laemo10/SuperNicePCB/report.txt

Mis à jour TestPoint de GND à GND1.
Annotation terminée.
