laemo10/SuperNicePCB/production/bom.csv

Designator | Footprint | Quantity | Value | LCSC Part #
3.3, 3V3_M, 3V3_S, GND_2, GND | TestPoint_Pad_1.0x1.0mm | 5 | TestPoint
BOOT | PinHeader_1x02_P1.27mm_Vertical_SMD_Pin1Left | 1 | Boot Opt | C703015
C1 | C1859_C1206 | 1 | 22uF | C1859
C10, C11, C5 | C109448_C0603 | 3 | 22uF | C109448
C12, C6, C9 | C1589_C0603 | 3 | 10nF | C1589
C13, C20, C7 | C1713_C0805 | 3 | 10uF | C1713
C14, C15, C17, C18, C19, C2, C3 | C1525_C0402 | 7 | 100nF | C1525
C16 | C1705_C0603 | 1 | 4,7uF | C1705
C4 | C1592_C0603 | 1 | 1uF | C1592
C8 | C76919_C0201 | 1 | 22pF | C76919
H1, H2, H3 | C52016809_HDR-SMD_14P-P2_54-V-M-S4_8 | 3 | 1010301753 | C52016809
L1 | C42100_IND-SMD_L4_0-W4_0 | 1 | 1.5uH | C42100
LED1 | C2289_LED0603-RD | 1 | 0603 | C2289
LED2 | C5139863_LED-SMD_L1_6-W0_8-RD_GREEN-1 | 1 | APHD1608LCGCK | C5139863
R1, R10, R11, R13, R14, R9 | C1489_R1206 | 6 | 10k | C1489
R12, R18, R4, R7 | C14675_R0603 | 4 | 100K | C14675
R15 | C4109_R0402 | 1 | 2K | C4109
R16, R17 | C13167_R0603 | 2 | 2.7k | C13167
R2, R3 | C14677_R0603 | 2 | 5.1K | C14677
R5 | C871504_R1206 | 1 | 90k | C871504
R6 | C4184_R0603 | 1 | 20K | C4184
R8 | C705066_R0402 | 1 | 3.2K | C705066
SW1 | C55200589_SW-SMD_4P-L4_2-W3_4-P2_15-LS5_2 | 1 | Reset | C55200589
U1 | C2913198_WIFIM-SMD_ESP32-S3-WROOM-1-N8 | 1 | ESP32-S3-WROOM-1-N8 | C2913198
U2 | C78988_SOT-23-5_L3_0-W1_7-P0_95-LS2_8-BR | 1 | SY8089AAAC | C78988
U3 | C3294704_VDFN-8_L3_0-W3_0-P0_65-BL-EP | 1 | SGM2048-ADJXTEK8G/TR | C3294704
U4 | C5656610_MIC-SMD_6P-L3_5-W2_7-P0_90-BL | 1 | ICS-43434_C5656610 | C5656610
U5 | C114881_TO-5-3_L8_2-W8_2 | 1 | AM312 | C114881
U6 | C3037696_LGA-20_L10_1-W10_1-P1_25-TL | 1 | SCD40-D-R1 | C3037696
U7 | C2848306_DFN-4_L1_5-W1_5-P0_8-TL-EP | 1 | SHT40-AD1B-R3 | C2848306
U8 | C37897213_SENSOR-TH_HLK-LD6002 | 1 | HLK-LD6002 | C37897213
U9 | C5299931_WIRELM-SMD_DWM3000TR13 | 1 | DWM3000TR13 | C5299931
UART | PinHeader_1x04_P1.27mm_Vertical_SMD_Pin1Left | 1 | UART Debug | C22438101
USBC1 | C165948_USB-C_SMD-TYPE-C-31-M-12_1 | 1 | TYPE-C-31-M-12 | C165948
