laemo10/SuperNicePCB/SuperNicePCB.kicad_pcb

## KiCad design SuperNicePCB.kicad_pcb (2026-10-15)

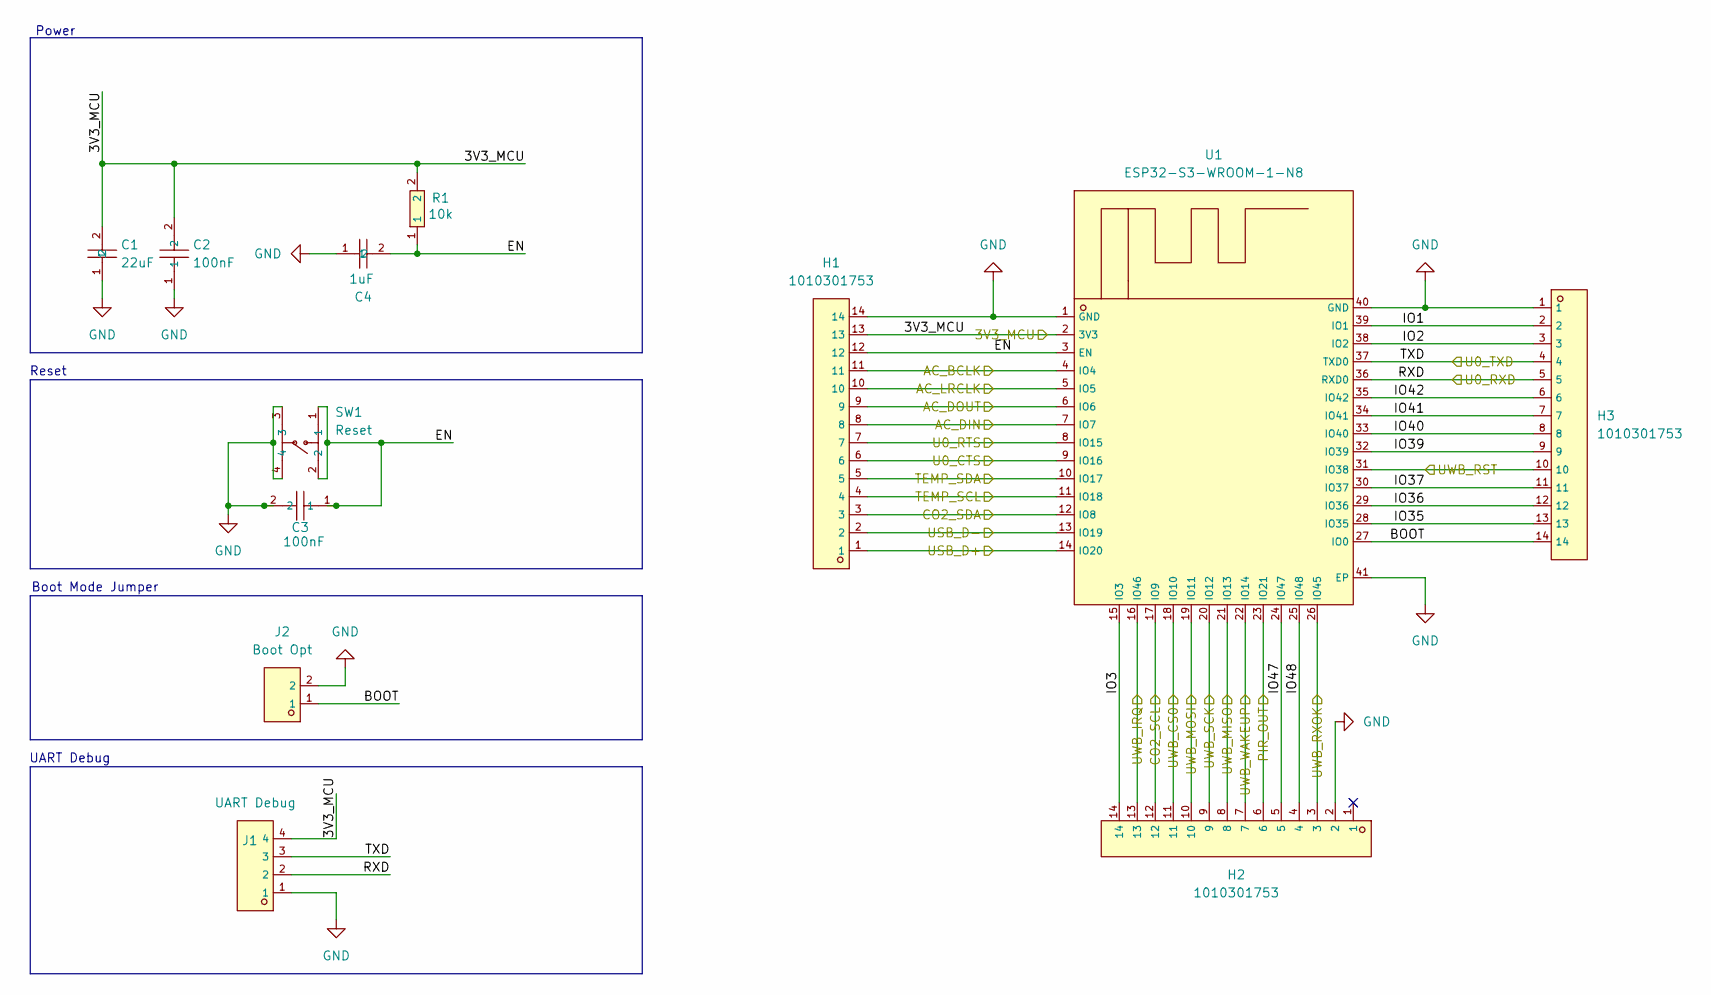
[picture p1: schematic MCU.kicad_sch]

Parts:
C1: 22uF; C1859_C1206; LCSC C1859
C2, C3: 100nF; C1525_C0402; LCSC C1525
C4: 1uF; C1592_C0603; LCSC C1592
H1, H2, H3: 1010301753; C52016809_HDR-SMD_14P-P2_54-V-M-S4_8; LCSC C52016809
J1: UART Debug; PinHeader_1x04_P1.27mm_Vertical_SMD_Pin1Left; LCSC C22438101
J2: Boot Opt; PinHeader_1x02_P1.27mm_Vertical_SMD_Pin1Left; LCSC C703015
R1: 10k; C1489_R1206; LCSC C1489
SW1: Reset; C55200589_SW-SMD_4P-L4_2-W3_4-P2_15-LS5_2; LCSC C55200589
U1: ESP32-S3-WROOM-1-N8; C2913198_WIFIM-SMD_ESP32-S3-WROOM-1-N8; LCSC C2913198

Connections:
/HumanSesors/AC_BCLK: H1.11, U1.4 (IO4); also elsewhere on the board
/HumanSesors/AC_LRCLK: H1.10, U1.5 (IO5); also elsewhere on the board
/HumanSesors/C02_SDA: H1.3, U1.12 (IO8); also elsewhere on the board
/HumanSesors/CO2_SCL: H2.12, U1.17 (IO9); also elsewhere on the board
/HumanSesors/DIN: H1.8, U1.7 (IO7); also elsewhere on the board
/HumanSesors/U0_CTS: H1.6, U1.9 (IO16); also elsewhere on the board
/HumanSesors/U0_RTS: H1.7, U1.8 (IO15); also elsewhere on the board
/MCU/3V3_MCU: C1.2, C2.2, H1.13, J1.4, R1.2, U1.2 (3V3); also elsewhere on the board
/MCU/AC_DOUT: H1.9, U1.6 (IO6)
/MCU/BOOT: H3.14, J2.1, U1.27 (IO0); also elsewhere on the board
/MCU/EN: C3.1, C4.2, H1.12, R1.1, SW1.1, SW1.2, U1.3 (EN)
/MCU/IO1: H3.2, U1.39 (IO1)
/MCU/IO2: H3.3, U1.38 (IO2)
/MCU/IO3: H2.14, U1.15 (IO3)
/MCU/IO35: H3.13, U1.28 (IO35)
/MCU/IO36: H3.12, U1.29 (IO36)
/MCU/IO37: H3.11, U1.30 (IO37)
/MCU/IO39: H3.9, U1.32 (IO39)
/MCU/IO40: H3.8, U1.33 (IO40)
/MCU/IO41: H3.7, U1.34 (IO41)
/MCU/IO42: H3.6, U1.35 (IO42)
/MCU/IO47: H2.5, U1.24 (IO47)
/MCU/IO48: H2.4, U1.25 (IO48)
/MCU/RXD: H3.5, J1.2, U1.36 (RXD0); also elsewhere on the board
/MCU/TXD: H3.4, J1.3, U1.37 (TXD0); also elsewhere on the board
/MCU/UWB_CS0: H2.11, U1.18 (IO10); also elsewhere on the board
/MCU/UWB_IRQ: H2.13, U1.16 (IO46); also elsewhere on the board
/MCU/UWB_MISO: H2.8, U1.21 (IO13); also elsewhere on the board
/MCU/UWB_MOSI: H2.10, U1.19 (IO11); also elsewhere on the board
/MCU/UWB_RST: H3.10, U1.31 (IO38); also elsewhere on the board
/MCU/UWB_RXOK: H2.3, U1.26 (IO45); also elsewhere on the board
/MCU/UWB_SCK: H2.9, U1.20 (IO12); also elsewhere on the board
/MCU/UWB_WAKEUP: H2.7, U1.22 (IO14); also elsewhere on the board
/PIR_OUT: H2.6, U1.23 (IO21); also elsewhere on the board
/TEMP_SCL: H1.4, U1.11 (IO18); also elsewhere on the board
/TEMP_SDA: H1.5, U1.10 (IO17); also elsewhere on the board
/USB_D+: H1.1, U1.14 (IO20); also elsewhere on the board
/USB_D-: H1.2, U1.13 (IO19); also elsewhere on the board
GND: C1.1, C2.1, C3.2, C4.1, H1.14, H2.2, H3.1, J1.1, J2.2, SW1.3, SW1.4, U1.1 (GND), U1.40 (GND), U1.41 (EP); also elsewhere on the board

Notes on the sheet:
Boot Mode Jumper
Power
UART Debug
Reset

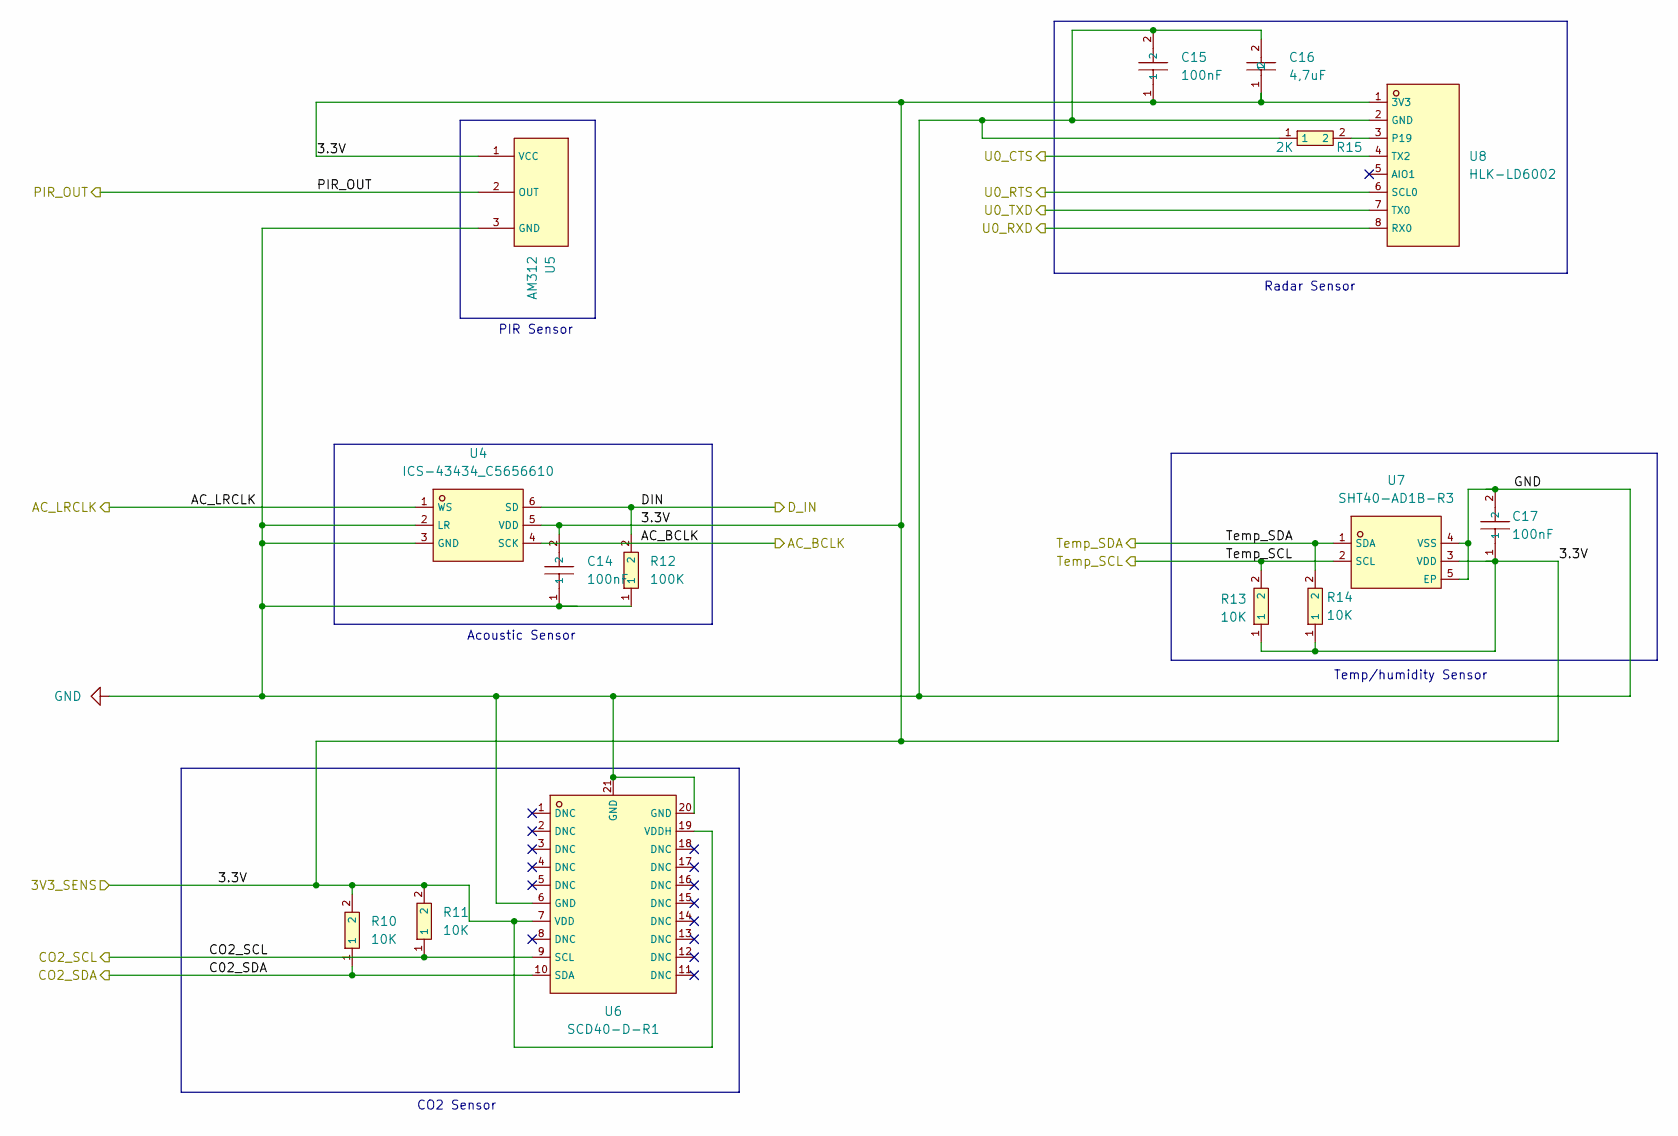
[picture p2: schematic HumanSensors.kicad_sch]

Parts:
C14, C15, C17: 100nF; C1525_C0402; LCSC C1525
C16: 4,7uF; C1705_C0603; LCSC C1705
R10, R11, R13, R14: 10K; C1489_R1206; LCSC C1489
R12: 100K; C14675_R0603; LCSC C14675
R15: 2K; C4109_R0402; LCSC C4109
U4: ICS-43434_C5656610; C5656610_MIC-SMD_6P-L3_5-W2_7-P0_90-BL; LCSC C5656610
U5: AM312; C114881_TO-5-3_L8_2-W8_2; LCSC C114881
U6: SCD40-D-R1; C3037696_LGA-20_L10_1-W10_1-P1_25-TL; LCSC C3037696
U7: SHT40-AD1B-R3; C2848306_DFN-4_L1_5-W1_5-P0_8-TL-EP; LCSC C2848306
U8: HLK-LD6002; C37897213_SENSOR-TH_HLK-LD6002; LCSC C37897213

Connections:
/HumanSesors/3.3V: C14.2, C15.1, C16.1, C17.1, R10.2, R11.2, R13.1, R14.1, U4.5 (VDD), U5.1 (VCC), U6.7 (VDD), U6.19 (VDDH), U7.3 (VDD), U8.1 (3V3); also elsewhere on the board
/HumanSesors/AC_BCLK: U4.4 (SCK); also elsewhere on the board
/HumanSesors/AC_LRCLK: U4.1 (WS); also elsewhere on the board
/HumanSesors/C02_SDA: R10.1, U6.10 (SDA); also elsewhere on the board
/HumanSesors/CO2_SCL: R11.1, U6.9 (SCL); also elsewhere on the board
/HumanSesors/DIN: R12.2, U4.6 (SD); also elsewhere on the board
/HumanSesors/U0_CTS: U8.4 (TX2); also elsewhere on the board
/HumanSesors/U0_RTS: U8.6 (SCL0); also elsewhere on the board
/MCU/RXD: U8.8 (RX0); also elsewhere on the board
/MCU/TXD: U8.7 (TX0); also elsewhere on the board
/PIR_OUT: U5.2 (OUT); also elsewhere on the board
/TEMP_SCL: R13.2, U7.2 (SCL); also elsewhere on the board
/TEMP_SDA: R14.2, U7.1 (SDA); also elsewhere on the board
GND: C14.1, C15.2, C16.2, C17.2, R12.1, R15.1, U4.2 (LR), U4.3 (GND), U5.3 (GND), U6.6 (GND), U6.20 (GND), U6.21 (GND), U7.4 (VSS), U7.5 (EP), U8.2 (GND); also elsewhere on the board
unnamed: R15.2, U8.3 (P19)

Notes on the sheet:
Acoustic Sensor
PIR Sensor
Radar Sensor
Temp/humidity Sensor
CO2 Sensor

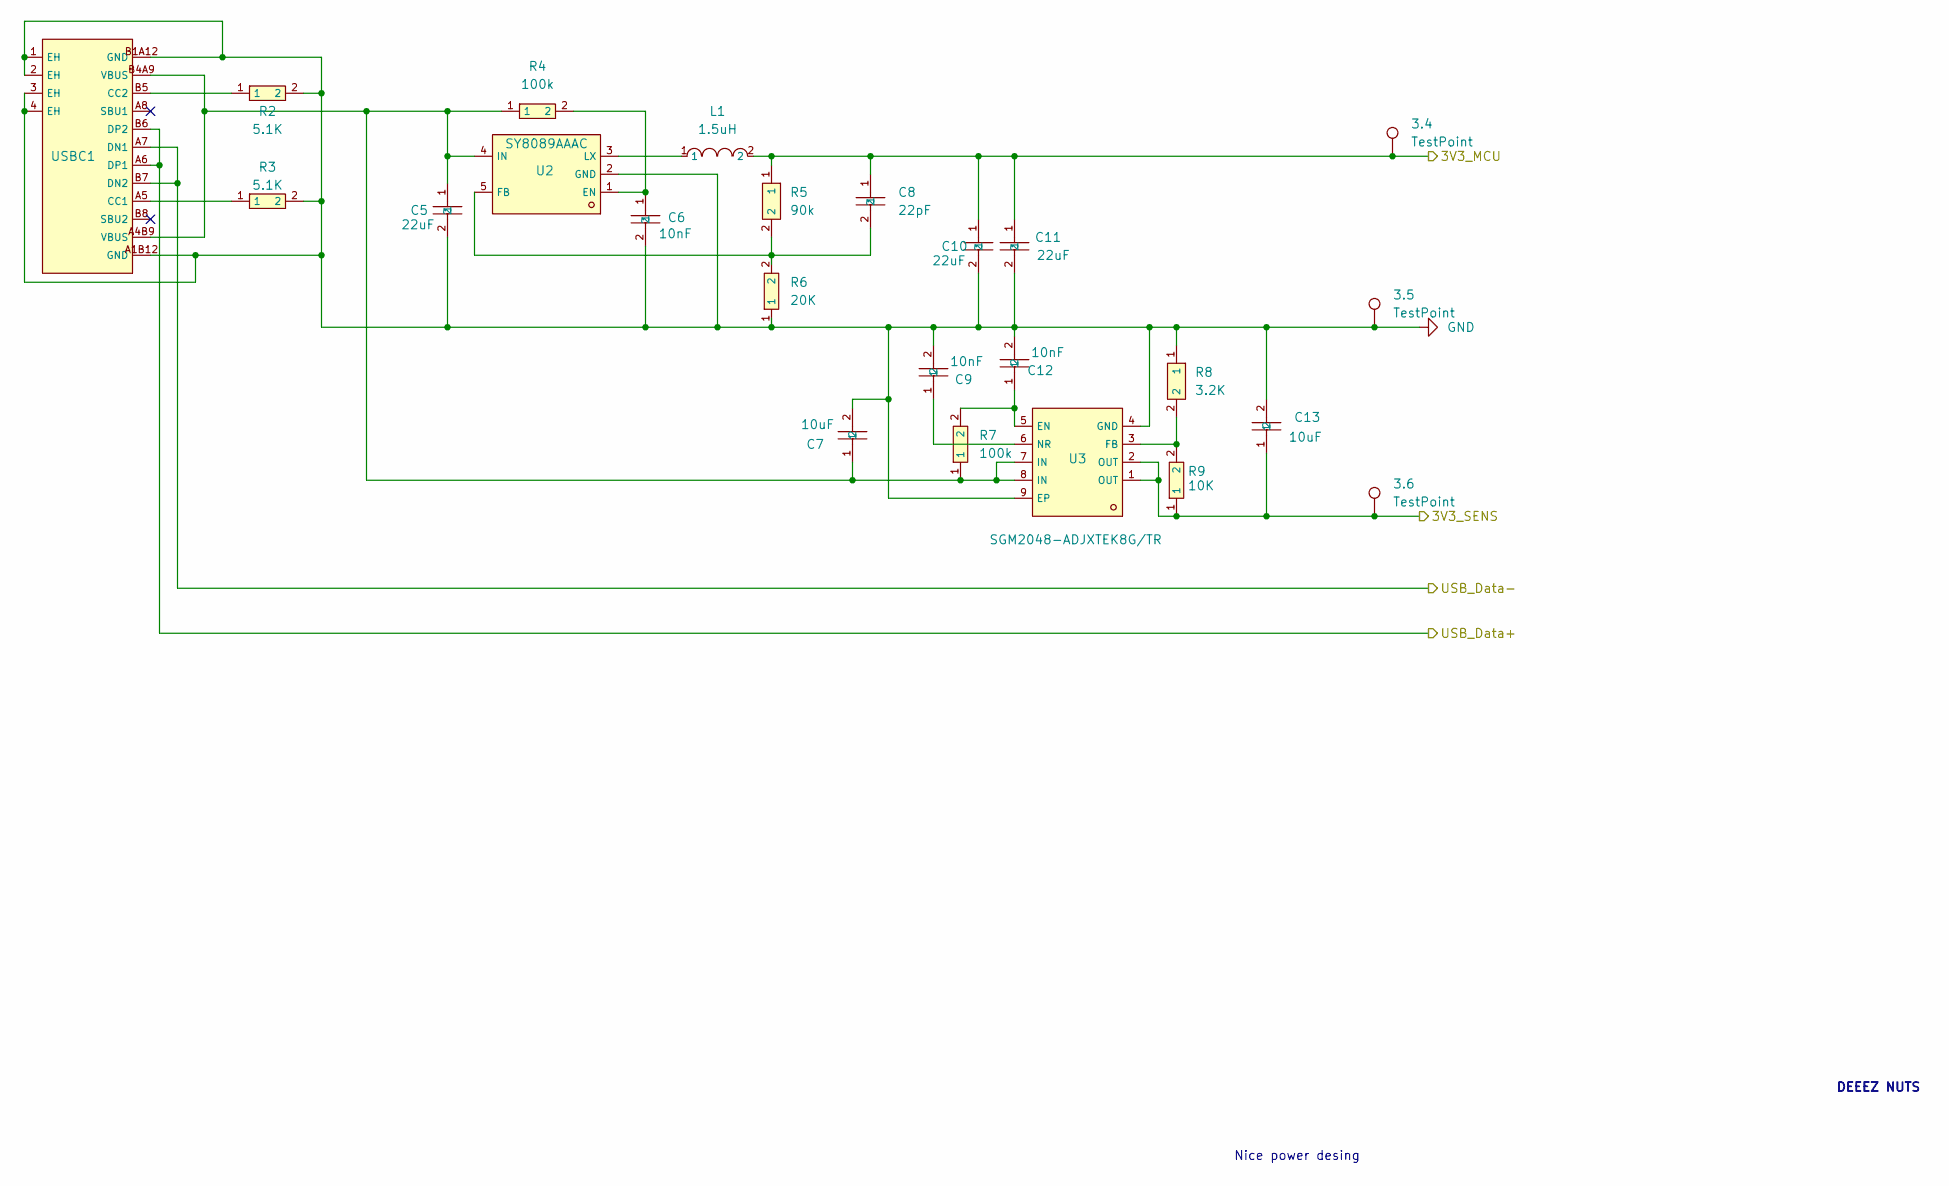
[picture p3: schematic Power.kicad_sch]

Parts:
3.4, 3.5, 3.6: TestPoint; TestPoint_Pad_1.0x1.0mm
C5, C10, C11: 22uF; C109448_C0603; LCSC C109448
C6, C9, C12: 10nF; C1589_C0603; LCSC C1589
C7, C13: 10uF; C1713_C0805; LCSC C1713
C8: 22pF; C76919_C0201; LCSC C76919
L1: 1.5uH; C42100_IND-SMD_L4_0-W4_0; LCSC C42100
R2, R3: 5.1K; C14677_R0603; LCSC C14677
R4, R7: 100k; C14675_R0603; LCSC C14675
R5: 90k; C871504_R1206; LCSC C871504
R6: 20K; C4184_R0603; LCSC C4184
R8: 3.2K; C705066_R0402; LCSC C705066
R9: 10K; C1489_R1206; LCSC C1489
U2: SY8089AAAC; C78988_SOT-23-5_L3_0-W1_7-P0_95-LS2_8-BR; LCSC C78988
U3: SGM2048-ADJXTEK8G/TR; C3294704_VDFN-8_L3_0-W3_0-P0_65-BL-EP; LCSC C3294704
USBC1: TYPE-C-31-M-12; C165948_USB-C_SMD-TYPE-C-31-M-12_1; LCSC C165948

Connections:
/HumanSesors/3.3V: C13.1, R9.1, U3.1 (OUT), U3.2 (OUT); also elsewhere on the board
/MCU/3V3_MCU: C8.1, C10.1, C11.1, L1.2, R5.1; also elsewhere on the board
/USB_D+: USBC1.A6 (DP1), USBC1.B6 (DP2); also elsewhere on the board
/USB_D-: USBC1.A7 (DN1), USBC1.B7 (DN2); also elsewhere on the board
GND: C5.2, C6.2, C7.2, C9.2, C10.2, C11.2, C12.2, C13.2, R2.2, R3.2, R6.1, R8.1, U2.2 (GND), U3.4 (GND), U3.9 (EP), USBC1.1 (EH), USBC1.2 (EH), USBC1.3 (EH), USBC1.4 (EH), USBC1.A1B12 (GND), USBC1.B1A12 (GND); also elsewhere on the board
unnamed: C6.1, R4.2, U2.1 (EN)
unnamed: C8.2, R5.2, R6.2, U2.5 (FB)
unnamed: C5.1, C7.1, R4.1, R7.1, U2.4 (IN), U3.7 (IN), U3.8 (IN), USBC1.A4B9 (VBUS), USBC1.B4A9 (VBUS)
unnamed: L1.1, U2.3 (LX)
unnamed: C12.1, R7.2, U3.5 (EN)
unnamed: R8.2, R9.2, U3.3 (FB)
unnamed: C9.1, U3.6 (NR)
unnamed: R3.1, USBC1.A5 (CC1)
unnamed: R2.1, USBC1.B5 (CC2)

Notes on the sheet:
Nice power desing
DEEEZ NUTS

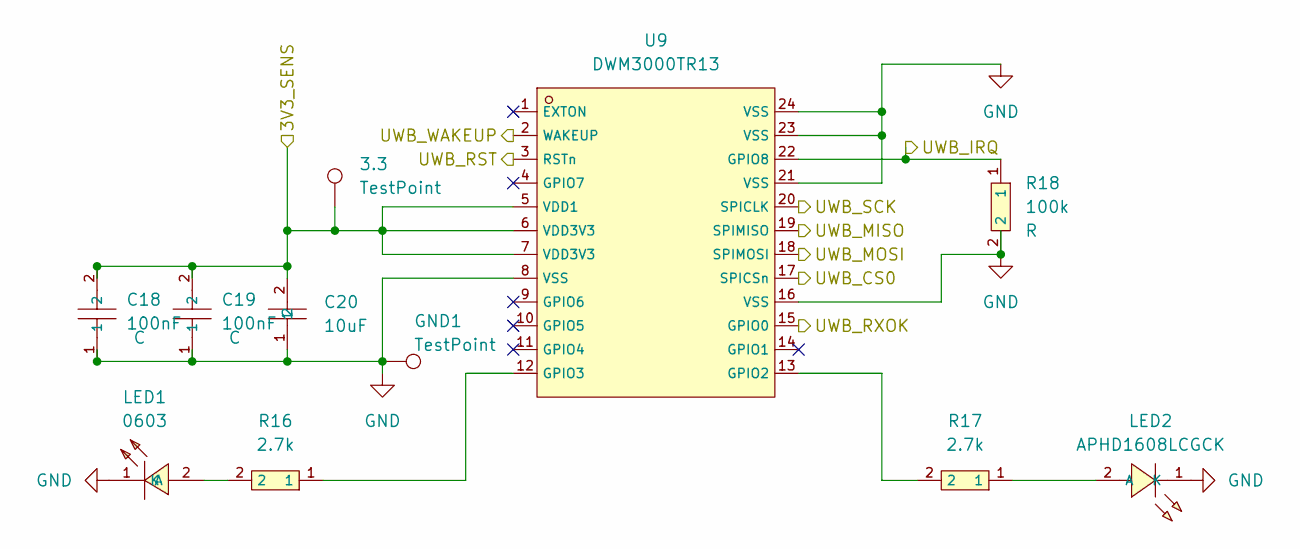
[picture p4: schematic UWB.kicad_sch]

Parts:
3.3: TestPoint; TestPoint_Pad_1.0x1.0mm
C18, C19: 100nF; C1525_C0402; LCSC C1525
C20: 10uF; C1713_C0805; LCSC C1713
GND1: TestPoint; TestPoint_Pad_1.0x1.0mm
LED1: 0603; C2289_LED0603-RD; LCSC C2289
LED2: APHD1608LCGCK; C5139863_LED-SMD_L1_6-W0_8-RD_GREEN-1; LCSC C5139863
R16, R17: 2.7k; C13167_R0603; LCSC C13167
R18: 100k; C14675_R0603; LCSC C14675
U9: DWM3000TR13; C5299931_WIRELM-SMD_DWM3000TR13; LCSC C5299931

Connections:
/HumanSesors/3.3V: 3.3.1 (1_1), C18.2, C19.2, C20.2, U9.5 (VDD1), U9.6 (VDD3V3), U9.7 (VDD3V3); also elsewhere on the board
/MCU/UWB_CS0: U9.17 (SPICSn); also elsewhere on the board
/MCU/UWB_IRQ: R18.1, U9.22 (GPIO8); also elsewhere on the board
/MCU/UWB_MISO: U9.19 (SPIMISO); also elsewhere on the board
/MCU/UWB_MOSI: U9.18 (SPIMOSI); also elsewhere on the board
/MCU/UWB_RST: U9.3 (RSTn); also elsewhere on the board
/MCU/UWB_RXOK: U9.15 (GPIO0); also elsewhere on the board
/MCU/UWB_SCK: U9.20 (SPICLK); also elsewhere on the board
/MCU/UWB_WAKEUP: U9.2 (WAKEUP); also elsewhere on the board
GND: C18.1, C19.1, C20.1, GND1.1, LED1.1 (K), LED2.1 (K), R18.2, U9.8 (VSS), U9.16 (VSS), U9.21 (VSS), U9.23 (VSS), U9.24 (VSS); also elsewhere on the board
unnamed: LED1.2 (A), R16.2
unnamed: LED2.2 (A), R17.1
unnamed: R17.2, U9.13 (GPIO2)
unnamed: R16.1, U9.12 (GPIO3)

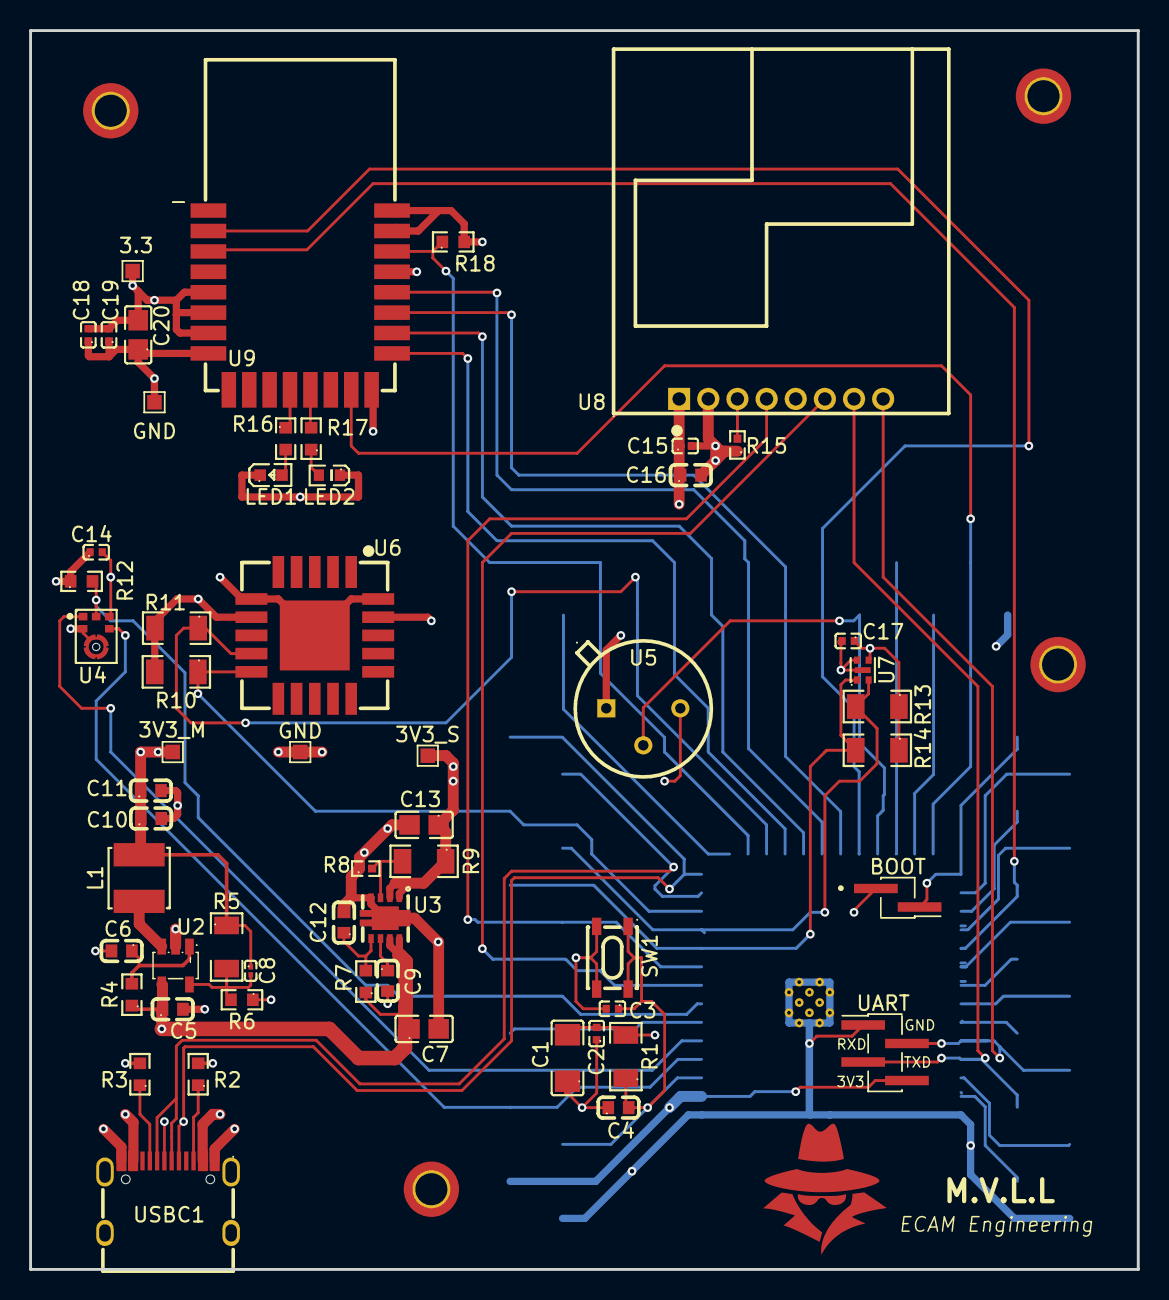
[picture p5: board SuperNicePCB.kicad_pcb from above]

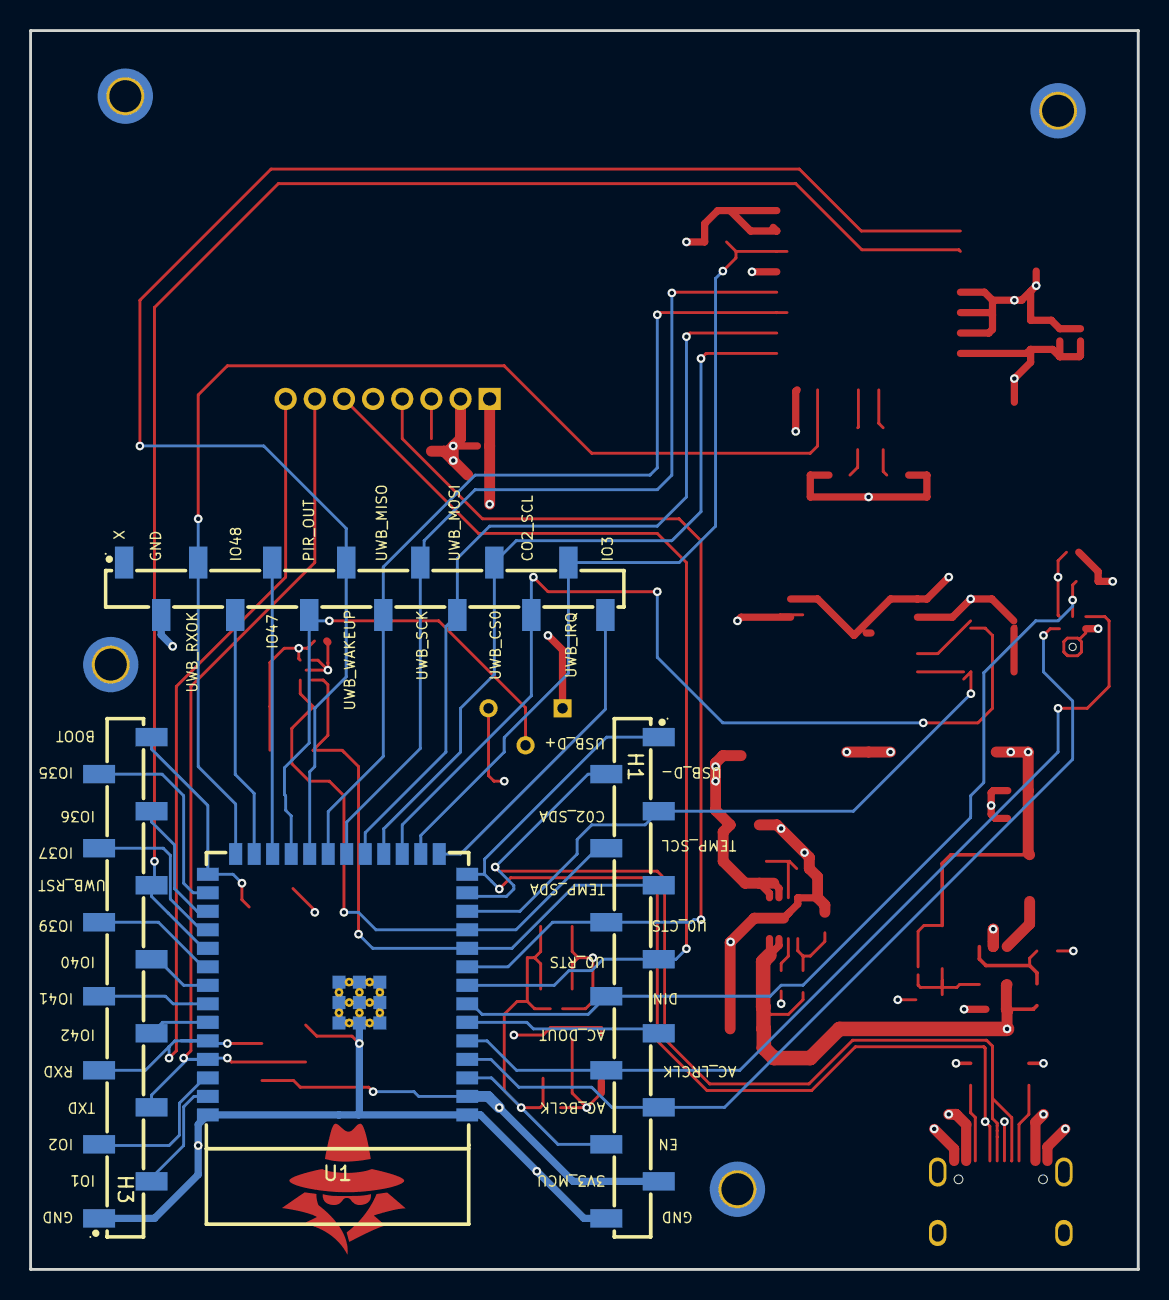
[picture p6: board SuperNicePCB.kicad_pcb from below]

Board: 4 copper layers, 76.0 x 85.0 mm, 62 parts (4 on the bottom side), 54 nets.

Other parts of the board:
3V3_M, 3V3_S: TestPoint; TestPoint_Pad_1.0x1.0mm
BOOT: Boot Opt; PinHeader_1x02_P1.27mm_Vertical_SMD_Pin1Left
GND: TestPoint; TestPoint_Pad_1.0x1.0mm
GND#2: TestPoint; TestPoint_Pad_1.0x1.0mm
UART: UART Debug; PinHeader_1x04_P1.27mm_Vertical_SMD_Pin1Left

Their connections:
/HumanSesors/3.3V: 3V3_S.1 (1_1); also elsewhere on the board
/MCU/3V3_MCU: 3V3_M.1 (1_1), UART.4; also elsewhere on the board
/MCU/BOOT: BOOT.1; also elsewhere on the board
/MCU/RXD: UART.2; also elsewhere on the board
/MCU/TXD: UART.3; also elsewhere on the board
GND: BOOT.2, GND.1 (1_1), GND#2.1 (1_1), UART.1; also elsewhere on the board
