laemo10/SuperNicePCB/(commit log)

2026-09-24 Initial snapshot: 3 files changed SuperNicePCB.kicad_pcb 2/0/0 SuperNicePCB.kicad_pro 1/0/0 SuperNicePCB.kicad_sch 14/0/0
    [SuperNicePCB.kicad_pcb, SuperNicePCB.kicad_sch]
2026-09-24 Adding gitignore
    [SuperNicePCB.kicad_pcb, SuperNicePCB.kicad_sch]
2026-09-24 Update root
    [SuperNicePCB.kicad_pcb, SuperNicePCB.kicad_sch]
2026-09-24 Add subsection
    [HumanSensors.kicad_sch, Power.kicad_sch, SuperNicePCB.kicad_sch, UWB.kicad_sch, mcu.kicad_sch]
2026-09-24 Buck converter for main power of the esp 32 and LDO converter for sensor
    Power Design
    [Power.kicad_sch]
2026-09-24 Beauty fixes
    [Power.kicad_sch]
2026-09-24 UWB: DWM3000 schematic with decoupling, IRQ pulldown and status LEDs
    [UWB.kicad_sch]
2026-09-24 Added global lables
    [Power.kicad_sch]
2026-09-24 Add project symbol and footprint libraries (LCSC imports)
2026-09-24 Global label modified
    [Power.kicad_sch]
2026-09-24 Add MCU
    [SuperNicePCB.kicad_pcb, mcu.kicad_sch]
2026-09-24 Human sensors
    [CO2sensors.kicad_sch, HumanSensors.kicad_sch, TemphumSensor.kicad_sch]
2026-09-24 UWB: restore full schematic (decoupling, LED resistors, IRQ pulldown, hierarchical labels)
    [UWB.kicad_sch]
2026-09-29 Clean: deduplicate symbol library and fix UUIDs
    - libs/lcsc/symbols/lcsc_imported.kicad_sym: merged 4 concatenated
    kicad_symbol_lib sections into one. Removed 8 duplicate symbol
    definitions (SCD40-D-R1, SHT40-AD1B-R3, DWM3000TR13, 0603,
    CC0603MRX5R5BB226, 22pF_(220), ESP32-S3-WROOM-1-N8 and their _1_1
    sub-units). Library reduced from 6407 to 4416 lines.
    - mcu.kicad_sch: fix duplicate UUIDs on decoupling cap pins
    - SuperNicePCB.kicad_sch: add missing UWB hierarchical label pins
    (UWB_CLK, UWB_CSn, UWB_IRQ, UWB_MISO, UWB_MOSI, UWB_RSTn, UWB_WAKE)
    - SuperNicePCB.kicad_pro: clear stale used_designators cache
    [SuperNicePCB.kicad_sch, mcu.kicad_sch]
2026-09-29 Ajout du label UWB_RXOK pour la pin GPIO 0
    [UWB.kicad_sch]
2026-09-29 Rework MCU and Human sensor
    [HumanSensors.kicad_sch, mcu.kicad_sch]
2026-09-29 Error correction
    Corrected resistor value for LDO and added slow rise resistor and capacitorfor LDO
    [Power.kicad_sch]
2026-09-29 Fix: repair symbol library structure from broken cherry-pick conflict
    The 'Error correction' cherry-pick (b00e793) introduced two issues
    in libs/lcsc/symbols/lcsc_imported.kicad_sym during conflict resolution:
    - An extra spurious ')' was inserted before RT0402BRD073K2L, causing
    kicad_symbol_lib to close prematurely (1 extra closing paren)
    - RT0402BRD073K2L symbol was placed at 0-indent instead of 2-indent
    Fixed by:
    - Removing the extra spurious ')'
    - Re-indenting RT0402BRD073K2L block to 2-space indent (standard format)
    - File now has 1 kicad_symbol_lib section, 27 unique symbols, balanced parens
    Also removed misplaced Power.kicad_pcb/ directory, Power.kicad_pro and
    Power.kicad_sch which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
    [Power.kicad_sch]
2026-09-29 Restore Power.kicad_sch (accidentally deleted in cleanup)
    [Power.kicad_sch]
2026-09-29 Final Routing
    [Power.kicad_sch, SuperNicePCB.kicad_sch, UWB.kicad_sch, mcu.kicad_sch]
2026-09-29 UWB: add test points
    [UWB.kicad_sch]
2026-09-29 refactor: reposition GPIO debug connector and update schematic wiring
    [UWB.kicad_sch, mcu.kicad_sch]
2026-09-30 Annotate whole schematic with per-sheet numbering (x100)
    [Power.kicad_sch, SuperNicePCB.kicad_pcb, UWB.kicad_sch]
2026-10-01 Changed the default symbols with JLC's one
    [HumanSensors.kicad_sch, UWB.kicad_sch, mcu.kicad_sch]
2026-10-01 Changed footprint of the test point
    [HumanSensors.kicad_sch, Power.kicad_sch, SuperNicePCB.kicad_pcb, UWB.kicad_sch, mcu.kicad_sch]
2026-10-01 PCB layout for power
    [SuperNicePCB.kicad_pcb]
2026-10-02 placement rework of sensors and uwb, installation of power plane, starting of routing , UWB sheet net names aligned with MCU
    [SuperNicePCB.kicad_pcb, UWB.kicad_sch]
2026-10-03 KiCad: PCB placement, routing and schematic updates
    Wiring of component blocks and sensors + component rearrangement + routing
    [HumanSensors.kicad_sch, SuperNicePCB.kicad_pcb, SuperNicePCB.kicad_sch, UWB.kicad_sch]
2026-10-03 Data lines layout. Missing power lines and UWB
    [Power.kicad_sch, SuperNicePCB.kicad_pcb, mcu.kicad_sch]
2026-10-04 Finish data lines
    [SuperNicePCB.kicad_pcb, SuperNicePCB.kicad_sch, UWB.kicad_sch, mcu.kicad_sch]
2026-10-04 Start debugging DRC
    [SuperNicePCB.kicad_pcb, SuperNicePCB.kicad_sch, mcu.kicad_sch]
2026-10-04 Power error correction/ redo of the wiring
    [SuperNicePCB.kicad_pcb]
2026-10-13 Wired MCU IO
2026-10-14 case sensitive
2026-10-14 Modified power routes/ added test point
2026-10-14 DRC: enlarge vias to 0.6/0.3mm (0.15mm annular ring, JLCPCB compliant)
2026-10-14 Fix footprint issues
2026-10-14 Connect power for uart debug
2026-10-15 Final version PCB fuck yeah
